rbobey1989/Ethercat_Slave_Axis_Interface/board/EthercatAxisInterface/EthercatAxisInterface.kicad_pcb

## KiCad design board/EthercatAxisInterface/EthercatAxisInterface.kicad_pcb (2026-05-12)

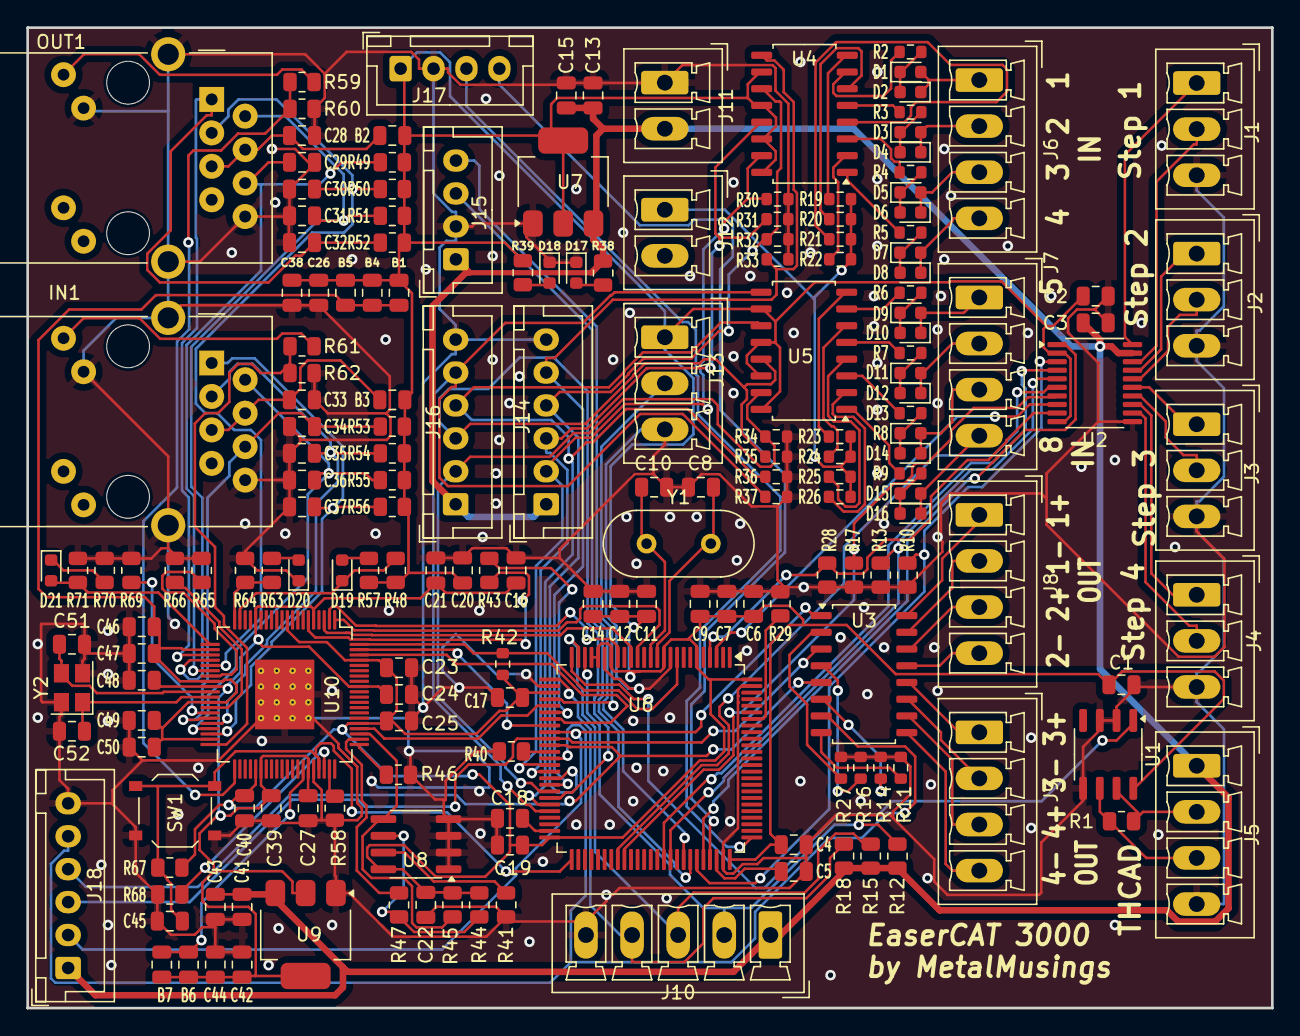
[picture p1: board EthercatAxisInterface.kicad_pcb from above]

Board: 2 copper layers, 94.5 x 74.4 mm, 184 parts (0 on the bottom side), 140 nets.

Parts:
B1, B4, B5, B6, B7: BLM18EG221SN1D; C_0805_2012Metric
B2, B3: BLM18EG221S; C_0805_2012Metric
C1, C2, C3, C4, C6, C7, C9, C11, C12, C14, C15, C16, C17, C19, C20, C21, C22, C23, C24, C25, C26, C27, C28, C33, C39, C40, C43, C44, C46, C47, C48, C49, C50: 0.1uF; C_0805_2012Metric
C5, C18: 2.2uF; C_0805_2012Metric
C8, C10: 22pF; C_0805_2012Metric
C13, C38, C41, C42: 10uF; C_0805_2012Metric
C29, C30, C31, C32, C34, C35, C36, C37: 10pF; C_0805_2012Metric
C45: 1uF; C_0805_2012Metric
C51, C52: 18pF; C_0805_2012Metric
D1, D3, D5, D7, D9, D11, D13, D15: Yellow led; LED_0603_1608Metric
D2, D4, D6, D8, D10, D12, D14, D16, D20: Red led; LED_0603_1608Metric
D17, D18: Blue led; LED_0603_1608Metric
D19, D21: Green led; LED_0603_1608Metric
IN1: J0011D01BNL; PulseJack JB0011D01BNL
J1: Step1; PhoenixContact_MCV_1,5_3-G-3.5_1x03_P3.50mm_Vertical
J2: Step2; PhoenixContact_MCV_1,5_3-G-3.5_1x03_P3.50mm_Vertical
J3: Step3; PhoenixContact_MCV_1,5_3-G-3.5_1x03_P3.50mm_Vertical
J4: Step4; PhoenixContact_MCV_1,5_3-G-3.5_1x03_P3.50mm_Vertical
J5: THCAD; PhoenixContact_MCV_1,5_4-G-3.5_1x04_P3.50mm_Vertical
J6: In1-4; PhoenixContact_MCV_1,5_4-G-3.5_1x04_P3.50mm_Vertical
J7: In5-8; PhoenixContact_MCV_1,5_4-G-3.5_1x04_P3.50mm_Vertical
J8: Output1-2; PhoenixContact_MCV_1,5_4-G-3.5_1x04_P3.50mm_Vertical
J9: Output3-4; PhoenixContact_MCV_1,5_4-G-3.5_1x04_P3.50mm_Vertical
J10: Encoder; PhoenixContact_MCV_1,5_5-G-3.5_1x05_P3.50mm_Vertical
J11: 5V Power IN; PhoenixContact_MCV_1,5_2-G-3.5_1x02_P3.50mm_Vertical
J12: 24V Field; PhoenixContact_MCV_1,5_2-G-3.5_1x02_P3.50mm_Vertical
J13: DAC; PhoenixContact_MCV_1,5_3-G-3.5_1x03_P3.50mm_Vertical
J14: In_opt1; JST_XH_B6B-XH-A_1x06_P2.50mm_Vertical
J15: Serial usart1; JST_XH_B4B-XH-A_1x04_P2.50mm_Vertical
J16: In_opt2; JST_XH_B6B-XH-A_1x06_P2.50mm_Vertical
J17: STLINK; JST_XH_B4B-XH-A_1x04_P2.50mm_Vertical
J18: Out_opt; JST_XH_B6B-XH-A_1x06_P2.50mm_Vertical
OUT1: J0011D01BNL; PulseJack JB0011D01BNL
R1: 120; R_0805_2012Metric
R2, R3, R4, R5, R6, R7, R8, R9, R42: 4k7; R_0603_1608Metric
R10, R13, R17, R28, R41, R44, R45, R46, R48, R64, R65, R67, R68, R69, R71: 4k7; R_0805_2012Metric
R11, R14, R16, R27: 330; R_0603_1608Metric
R12, R15, R18, R38, R39: 1k; R_0805_2012Metric
R19, R20, R21, R22, R23, R24, R25, R26: 1k; R_0603_1608Metric
R29, R40, R43, R47, R58: 22; R_0805_2012Metric
R30, R31, R32, R33, R34, R35, R36, R37: 39k; R_0603_1608Metric
R49, R50, R51, R52, R53, R54, R55, R56: 49.9; R_0805_2012Metric
R57, R59, R60, R61, R62, R63, R70: 510; R_0805_2012Metric
R66: 12k 1%; R_0805_2012Metric
SW1: SW PB; SW_Push_1P1T_XKB_TS-1187A
U1: MAX3485CSA/ESA; SO-8_3.9x4.9mm_P1.27mm
U2: TXS0108EPW; TSSOP-20_4.4x6.5mm_P0.65mm
U3, U4, U5: TLP292-4; SOIC-16_4.55x10.3mm_P1.27mm
U6: STM32F407VGT6; LQFP-100_14x14mm_P0.5mm
U7: AMS1117-3.3; SOT-223-3_TabPin2
U8: 24LC32A; SOIC-8_3.9x4.9mm_P1.27mm
U9: AMS1117-1.2; SOT-223-3_TabPin2
U10: AX58100; LQFP-80-1EP_10x10mm_P0.4mm_EP5.3x4.5mm_ThermalVias
Y1: 8 MHz; Crystal_HC49-4H_Vertical
Y2: NXK25.000AE12F-KAB6-12; Crystal_SMD_SeikoEpson_TSX3225-4Pin_3.2x2.5mm

Connections:
+1V2: B6.1, B7.1, C16.1, C21.1, C24.1, C27.1, C39.1, C42.1, C44.1, C48.1, U9.2 (VO), U10.5 (VCCK), U10.16 (VCCK), U10.29 (VCCK), U10.46 (VCCK), U10.55 (VCCK), U10.72 (VCCK)
+3.3V: B1.1, B2.1, B3.1, B4.1, B5.1, C1.1, C2.1, C4.1, C6.1, C7.1, C9.1, C11.1, C12.1, C14.1, C17.1, C19.1, C20.1, C22.2, C23.1, C25.1, C26.1, C38.1, C40.1, J13.1, J17.1, R39.2, R42.2, R44.1, R45.1, R48.1, R49.2, R50.2, R51.2, R52.2, R53.2, R54.2, R55.2, R56.2, R57.1, R67.2, U1.8 (VCC), U2.2 (VCCA), U2.10 (OE), U4.10, U4.12, U4.14, U4.16, U5.10, U5.12, U5.14, U5.16, U6.6 (VBAT), U6.11 (VDD), U6.19 (VDD), U6.21 (VREF+), U6.22 (VDDA), U6.28 (VDD), U6.50 (VDD), U6.75 (VDD), U6.100 (VDD), U7.2 (VO), U8.8 (VCC), U10.10 (VCC3IO), U10.45 (VCC3IO), U10.65 (VCC3IO), U10.77 (VCC3IO)
+3.3VA: B1.2, B4.2, B5.2, C46.1, C47.1, C49.1, C50.1, U10.22 (VCC33A), U10.28 (VCC33A), U10.32 (VCC33A), U10.39 (VCC33A)
+5V: C3.1, C13.1, C15.1, C41.1, C43.1, J5.1, J10.1, J11.2, J14.1, J15.1, J16.1, J18.1, R12.2, R15.2, R18.2, R38.2, U2.19 (VCCB), U7.3 (VI), U9.3 (VI)
-24V_FIELD: J12.1, R19.2, R20.2, R21.2, R22.2, R23.2, R24.2, R25.2, R26.2
/STM32F4/BOOT1: R40.2, U6.37 (PB2)
A1V2: B6.2, B7.2, U10.54 (VCC12A_PLL)
DAC1: J13.2, U6.29 (PA4)
EEP_DONE: D21.2 (A), R71.2, U10.21 (EEP_DONE)
ENC_A: J10.2, R12.1, U6.23 (PA0)
ENC_B: J10.3, R15.1, U6.24 (PA1)
ENC_Z: J10.4, R18.1, U6.26 (PA3)
GND: C1.2, C2.2, C3.2, C4.2, C5.1, C6.2, C7.2, C8.1, C9.2, C10.1, C11.2, C12.2, C13.2, C14.2, C15.2, C16.2, C17.2, C18.1, C19.2, C20.2, C21.2, C22.1, C23.2, C24.2, C25.2, C26.2, C27.2, C28.1, C29.1, C30.1, C31.1, C32.1, C33.1, C34.1, C35.1, C36.1, C37.1, C38.2, C39.2, C40.2, C41.2, C42.2, C43.2, C44.2, C45.2, C46.2, C47.2, C48.2, C49.2, C50.2, C51.2, C52.2, D17.1 (K), D18.1 (K), D20.1 (K), IN1.8 (CHS_GND), IN1.10, IN1.SH (CHS_GND), J1.3, J2.3, J3.3, J4.3, J5.4, J10.5, J11.1, J13.3, J14.6, J15.2, J16.6, J17.2, J18.6, OUT1.8 (CHS_GND), OUT1.10, OUT1.SH (CHS_GND), R10.1, R11.2, R13.1, R14.2, R16.2, R17.1, R27.2, R28.1, R29.1, R30.2, R31.2, R32.2, R33.2, R34.2, R35.2, R36.2, R37.2, R40.1, R41.2, R46.1, R58.2, R60.2, R62.2, R64.1, R65.2, R66.2, R68.1, R69.2, R70.1, R71.1, SW1.1, U1.2 (~RE), U1.3 (DE), U1.5 (GND), U2.11 (GND), U6.10 (VSS), U6.20 (VSSA), U6.27 (VSS), U6.74 (VSS), U6.99 (VSS), U7.1 (GND), U8.1 (A0), U8.2 (A1), U8.3 (A2), U8.4 (GND), U9.1 (GND), U10.56 (FM), U10.81 (GND_EPAD), Y2.2, Y2.4
I2C_SCL: R44.2, R47.1, U8.6 (SCL)
I2C_SDA: R45.2, U8.5 (SDA), U10.63 (I2C_SDA)
IO1: J18.2, U3.1, U6.34 (PC5)
IO2: J18.3, U3.3, U6.35 (PB0)
IO3: J18.4, U3.5, U6.36 (PB1)
IO4: J18.5, U3.7, U6.38 (PE7)
IO5: J14.2, R30.1, U4.15, U6.39 (PE8)
IO6: J14.3, R31.1, U4.13, U6.40 (PE9)
IO7: J14.4, R32.1, U4.11, U6.41 (PE10)
IO8: J14.5, R33.1, U4.9, U6.42 (PE11)
IO9: J16.2, R34.1, U5.15, U6.43 (PE12)
IO10: J16.3, R35.1, U5.13, U6.44 (PE13)
IO11: J16.4, R36.1, U5.11, U6.45 (PE14)
IO12: J16.5, R37.1, U5.9, U6.46 (PE15)
LED_ERR: R63.1, R64.2, U10.20 (LED_ERR)
LED_RUN: D19.1 (K), R48.2, U10.19 (LED_RUN)
unnamed: D1.2 (A), D2.1 (K), J6.1
unnamed: D1.1 (K), D2.2 (A), R2.1
unnamed: D3.2 (A), D4.1 (K), J6.2
unnamed: D3.1 (K), D4.2 (A), R3.1
unnamed: D5.2 (A), D6.1 (K), J6.3
unnamed: D5.1 (K), D6.2 (A), R4.1
unnamed: D7.2 (A), D8.1 (K), J6.4
unnamed: D7.1 (K), D8.2 (A), R5.1
unnamed: D9.1 (K), D10.2 (A), R6.1
unnamed: D9.2 (A), D10.1 (K), J7.1
unnamed: D11.2 (A), D12.1 (K), J7.2
unnamed: D11.1 (K), D12.2 (A), R7.1
unnamed: D13.2 (A), D14.1 (K), J7.3
unnamed: D13.1 (K), D14.2 (A), R8.1
unnamed: D15.2 (A), D16.1 (K), J7.4
unnamed: D15.1 (K), D16.2 (A), R9.1
unnamed: D17.2 (A), R38.1
unnamed: D18.2 (A), R39.1
unnamed: D19.2 (A), R57.2
unnamed: D20.2 (A), R63.2
unnamed: D21.1 (K), R70.2
unnamed: IN1.9, R61.2
unnamed: B3.2, C33.2, IN1.4 (TCT), IN1.5 (RCT)
unnamed: J5.2, R1.2, U1.7 (B)
unnamed: J5.3, R1.1, U1.6 (A)
unnamed: J8.1, U3.16
unnamed: J8.2, U3.15
unnamed: J8.3, U3.14
unnamed: J8.4, U3.13
unnamed: J9.1, U3.12
unnamed: J9.2, U3.11
unnamed: J9.3, U3.10
unnamed: J9.4, U3.9
unnamed: OUT1.9, R59.2
unnamed: B2.2, C28.2, OUT1.4 (TCT), OUT1.5 (RCT)
unnamed: R2.2, U4.7
unnamed: R3.2, U4.5
unnamed: R4.2, U4.3
unnamed: R5.2, U4.1
unnamed: R6.2, U5.7
unnamed: R7.2, U5.5
unnamed: R8.2, U5.3
unnamed: R9.2, U5.1
unnamed: R11.1, U3.8
unnamed: R14.1, U3.6
unnamed: R16.1, U3.4
unnamed: R19.1, U4.8
unnamed: R20.1, U4.6
unnamed: R21.1, U4.4
unnamed: R22.1, U4.2
unnamed: R23.1, U5.8
unnamed: R24.1, U5.6
unnamed: R25.1, U5.4
unnamed: R26.1, U5.2
unnamed: R27.1, U3.2
unnamed: R29.2, U6.94 (BOOT0)
unnamed: C8.2, U6.12 (PH0), Y1.2
unnamed: C10.2, U6.13 (PH1), Y1.1
unnamed: C18.2, U6.49 (VCAP_1)
unnamed: C5.2, U6.73 (VCAP_2)
unnamed: R41.1, U8.7 (WP)
unnamed: R47.2, U10.62 (I2C_SCL)
unnamed: R69.1, U10.34 (P0_SD)
unnamed: R65.1, U10.27 (P1_SD)
unnamed: R66.1, U10.33 (RESET_BG)
unnamed: R43.2, U10.6 (SPI_MISO)
unnamed: R58.1, U10.59 (TEST)
P0_ACT: R61.1, R62.1, U10.40 (P0_ACT)
P0_RXIN: C34.2, IN1.6 (RD-), R53.1, U10.35 (P0_RXIN)
P0_RXIP: C35.2, IN1.3 (RD+), R54.1, U10.36 (P0_RXIP)
P0_TXON: C36.2, IN1.2 (TD-), R55.1, U10.37 (P0_TXON)
P0_TXOP: C37.2, IN1.1 (TD+), R56.1, U10.38 (P0_TXOP)
P1_ACT: R59.1, R60.1, U10.41 (P1_ACT)
P1_RXIN: C29.2, OUT1.6 (RD-), R49.1, U10.26 (P1_RXIN)
P1_RXIP: C30.2, OUT1.3 (RD+), R50.1, U10.25 (P1_RXIP)
P1_TXON: C31.2, OUT1.2 (TD-), R51.1, U10.24 (P1_TXON)
P1_TXOP: C32.2, OUT1.1 (TD+), R52.1, U10.23 (P1_TXOP)
PDI_EMU: R46.2, U10.61 (PDI_EMU)
RESET_MCU: C45.1, R67.1, SW1.2, U6.51 (PB12), U10.57 (RSTn)
RSTO: R68.2, U10.58 (RSTO)
RX: J15.3, U6.69 (PA10)
SCS_FUNC: R42.1, U6.9 (PC15), U10.80 (SCS_FUNC)
SINT: U6.15 (PC0), U10.1 (SPI_INT)
SPI_CS: U6.33 (PC4), U10.79 (SCS_ESC)
SPI_MISO: R43.1, U6.31 (PA6)
SPI_MOSI: U6.32 (PA7), U10.78 (SPI_MOSI)
SPI_SCK: U6.30 (PA5), U10.64 (SPI_CLK)
STEP1_DIR: U2.1 (A1), U6.71 (PA12)
STEP1_DIR_OUT: J1.1, U2.20 (B1)
STEP1_STEP: R10.2, U2.3 (A2), U6.70 (PA11)
STEP1_STEP_OUT: J1.2, U2.18 (B2)
STEP2_DIR: U2.4 (A3), U6.65 (PC8)
STEP2_DIR_OUT: J2.1, U2.17 (B3)
STEP2_STEP: R13.2, U2.5 (A4), U6.66 (PC9)
STEP2_STEP_OUT: J2.2, U2.16 (B4)
STEP3_DIR: U2.6 (A5), U6.58 (PD11)
STEP3_DIR_OUT: J3.1, U2.15 (B5)
STEP3_STEP: R17.2, U2.7 (A6), U6.59 (PD12)
STEP3_STEP_OUT: J3.2, U2.14 (B6)
STEP4_DIR: U2.8 (A7), U6.3 (PE4)
STEP4_DIR_OUT: J4.1, U2.13 (B7)
STEP4_STEP: R28.2, U2.9 (A8), U6.4 (PE5)
STEP4_STEP_OUT: J4.2, U2.12 (B8)
SWCLK: J17.3, U6.76 (PA14)
SWDIO: J17.4, U6.72 (PA13)
SYNC0: U6.18 (PC3), U10.2 (SYNC_L0)
SYNC1: U6.16 (PC1), U10.3 (SYNC_L1)
THCAD_CTR: U1.1 (RO), U6.25 (PA2)
TX: J15.4, U6.68 (PA9)
XSCI: C52.1, U10.31 (XSCI), Y2.1
XSCO: C51.1, U10.30 (XSCO), Y2.3
