rbobey1989/Ethercat_Slave_Axis_Interface/applications/esc_ax58100_soes_phy_eeprom_app/src/servo.h

#ifndef SERVO_H
#define SERVO_H

#include <stdint.h>

void servo_init(void);
void servo_load_static_config(void);
void servo_cycle(void);
void servo_fast_cycle(void);

extern volatile uint8_t g_servo_fast_ticks;

#endif /* SERVO_H */
