rbobey1989/Ethercat_Slave_Axis_Interface/applications/esc_ax58100_soes_emu_eeprom_app/src/system_clock.h

/* system_clock.h - System clock configuration (HSI -> PLL 168MHz) */
#ifndef __SYSTEM_CLOCK_H
#define __SYSTEM_CLOCK_H

#ifdef __cplusplus
extern "C" {
#endif

void SystemClock_Config(void);

#ifdef __cplusplus
}
#endif

#endif /* __SYSTEM_CLOCK_H */
