rbobey1989/Ethercat_Slave_Axis_Interface/(commit log)

2026-05-06 Añadido readme PIN_USAGE.md con el recuento de pines por app, se ha implementado para probar la emulacion de eeprom en su app correspondiente
2026-05-07 añadido captura de canal z, expuesto por PDO Status Level y Latch
2026-05-07 actualización de remapeo de pines GPIOs
2026-05-12 añadido modulo vel_ctrl
    [AX58100_00.kicad_sch, AX58100_01.kicad_sch, Axis.kicad_sch, EthercatAxisInterface.kicad_pcb, EthercatAxisInterface.kicad_sch, Inputs_Interface.kicad_sch, Outputs_Interface.kicad_sch, STM32F4.kicad_sch]
2026-05-13 se cambia el estimador de velocidad y se cambia la arquitectura de la placa a 2 ejes
